damienmg/ender3_control_box/tank-hotend/params.scad

BLTOUCH_OFFSET = [40,0,0];
