damienmg/ender3_control_box/dual_z_plate/components.scad

use <3rdparty/Ender3/ender3.scad>

module Components() {
    Ender3WithoutScreen();
}

Components();
