damienmg/ender3_control_box/(list of files, cad)

Other CAD files:
psu_sonoff_cover/params.scad
control_box/colors.scad
