damienmg/ender3_control_box/(commit log)

2019-04-17 Added 3rd party STL for sizing.
2019-04-17 Added iteration 1 of the control box
    This control box enable to power the Raspberry Pi from the PSU of the
    Ender 3 and control the power of the printer itself, the power of a LED
    stripe and fans for the control box (cooling the RPi and the Buck
    converters).
    The Raspberry Pi control those using a Google AIY Voice Kit V1 (I use
    the servo control) but it can be done directly from the GPIO of the
    voice kit (just needs more wiring logic). I also intend to add an
    auxiliary box for the mic and the speaker of the Voice Kit so I can
    control my printer by voice :)
    Fixing is done using a mix of snap fit feet and brass inserts.
    [control_box.scad]
2019-04-17 Adapt the side fit in the extrusion
    The fit are good enough to hold the whole box, and the size should make
    them perfect to fit on the side of the Ender 3.
    [control_box.scad]
2019-04-17 Move the opening for the raspberry pi a bit higher
    It seems to be a bit too low currently (used a file to adapt it).
    [control_box.scad]
2019-05-20 Add a PSU cover for extra wire.
    It's probably not going to be used in fine.
    [psu_cover.scad]
2019-07-07 Initial redesign of the control box.
    This design is still pretty rough but should be printer for test. The
    front part is probably the first one to print since it can change the
    design of everything else. Second part to print would be the upper
    layer.
    The first thing to verify is that this does not prevent the Z axis from
    going all the way down.
    [control_box.scad, control_box_component_positions.scad, control_box_components.scad, psu_cover.scad]
2019-08-03 v2 of the box fixes after printing the front part
    This was testing with support enforcer on the front endcap and on the
    slider for the 40x40 extrusion. Pretty good except:
    - Add TODO for better support (e.g. missing support on the clip, too
    much support elsewhere).
    - The box was too high and colliding with the X gantry.
    - The endcap was in the wrong direction :)
    [control_box.scad]
2019-08-03 Adjust screw insert dimensions.
    [control_box.scad]
2019-08-03 Move the MOSFET cooling to be at the correct position
    [control_box.scad]
2019-08-03 Fix various position of the upper level after change of board dimensions.
    [control_box.scad]
2019-08-03 Reduce the size of the aluminum extrusion slider
    So they do not touch the endcap and prevent having support impossible
    to remove merge in between (although this could be solved in the slicer,
    it is better to fix it in the project).
    [control_box.scad]
2019-08-03 Add clearance for the upper level to go through
    Those clearance are so small that they should not need support.
    [control_box.scad]
2019-08-03 Make the lower bracket thicker (more solid)
    [control_box.scad]
2019-08-03 Decrease a bit the distance between step-down converter feet.
    They were too far apart from my LM2596S.
    [control_box.scad]
2019-08-03 Rewrite the endcap to be able to play for the size
    The one provided by Creality are too big to fit in the 40x40 extrusion,
    with some clearance they fit easily.
    [control_box.scad]
2019-08-03 Added some clearance to the endcap insert
    [control_box.scad]
2019-08-03 Cut out the part of the SKR13 feets that goes outside the board
    [control_box.scad]
2019-08-03 Fix M2 insert by doing through all insert
    Inserting the insert push plastic underneath and with just the good size
    the plastic come back inside the insert, clogging it. By using through
    all holes, we let space for the M2 insert plastic to be ejected.
    Also: remove trailing spaces
    [control_box.scad, control_box_components.scad]
2019-08-03 Raise the position of the mainboard port by 1mm
    The current print has the port 1 mm too low.
    [control_box.scad]
2019-08-03 Hopefully last adjustment for the upper level.
    - Fix the screw hole through size. It was always doing a M2 hole.
    - Increase the upper level bracket size to fit wire
    - Increase the upper level cable in hole size to fit wire
    - Add 1mm clearance (half a millimeter each side) on the bottom plate
    - Remove the power cable hole. The cable made assembly impossible so it
    is better to pass also the power by the other side.
    - Fix M2 and M3 insert size. There is a need to adjust them all.
    [control_box.scad]
2019-08-03 Several improvements after last print
    - removed pin for relay (plain feet)
    - removed bracket on the lower level (useless)
    - reduced the height of the raspberry pi USB port hole by 1mm
    (there was a 2.4mm clearance, too much).
    - removed part of the speaker support that block the upper level.
    - increased width clearance for the upper attachment.
    - added clearance on the cover to allow for it to slide nicely.
    - added cantilevers to force the 2 lower part to fit together.
    [control_box.scad]
2019-08-03 Remove some lug to increase the size of the cantilever
    [control_box.scad]
2019-08-03 Added proper position for the Raspberry Pi Standoffs
    [control_box.scad]
2019-08-03 Add fillets in a couple of places
    This make the edges of the box smoother.
    [control_box.scad]
2019-08-03 Cover: increase the length by 3 mm, total length by 1
    The insert that goes below the screen is now filletted and should
    adhere better to the screen inclination as well as print better without
    support.
    [control_box.scad]
2019-08-03 PCB snap fit: adjust a bit the clearance
    The previous version was too fit, there was not enough clearance and it
    was exercising to much stress on the PCB and on the snap fit.
    [control_box.scad]
2019-08-03 Upper level: do go through for the SKR 1.3 insert
    [control_box.scad]
2019-08-03 Add Apache 2.0 License and README
    [control_box.scad, control_box_component_positions.scad, control_box_components.scad]
2019-08-14 Adding a Bazel build to the SCAD files.
    This should allow good automation to generate all the artifact needed
    for printing. Hopefully I can complete that with some 3MF generation to
    handle support generation.
    [control_box.scad]
2019-08-14 Extract the colors in a separate scad file
    [colors.scad, control_box.scad, control_box_components.scad]
2019-08-14 Replace `for(...) children(c)` by `children()`
    [control_box.scad]
2019-08-14 Moved all the parameters to a separate params file
    Make it easier for people to adjust to their needs.
    [control_box.scad, params.scad]
2019-08-14 Update the brass inserts' diameters
    Set them to the full external diameter minus 1 mm. Before
    that they were set to the middle external diameter (where
    the brass is the thinner) but this was moving out too much
    plastic. This dimensions make it easy to insert those brass.
    [params.scad]
2019-08-15 Add custom support directly in the OpenSCAD model
    Slicer's support have been pretty bad and hard to remove. Try adding
    custom support that would be printed as part of the model.
    [colors.scad, control_box.scad, params.scad]
2019-08-17 Improve upper level
    - Increase size for MOSFET cooling.
    - Remove excessive cable bracket to only keep the useful one.
    - Remove a fixation hole that was inaccessible when needed.
    - Add a chamfer to the side to improve clearance when sliding the upper
    level in the box.
    [control_box.scad]
2019-08-17 Add a couple of bracket in the front of the box
    This should help with cable management a bit.
    [control_box.scad]
2019-08-17 Add place to attach a ziptie zipped around the cable
    [control_box.scad]
2019-08-17 Add better fixation for the upper cover
    This cover is now holded to all part of the box using a special slides.
    This should make sure the cover does not pop up at some place.
    [control_box.scad]
2019-08-17 Chamfer a last part that was having a steep overhang
    [control_box.scad]
2019-08-21 Lower the screen by 2 mm
    As measured by my caliper there seems to be 2 mm gap between the
    screen top and the box height.
    [control_box.scad, params.scad]
2019-08-21 Cover slide fit: reduce clearance and increase size
    This version result in almost no other movement than along the sliding
    direction.
    [control_box.scad]
2019-08-25 Add some interface layers to the support
    Theses interface layers draw a non continous part to ensure they do not
    stick hard on the part itself.
    Also increase the gap between support and wall as 0.5 is too close to
    the extrusion width and was fusing with the wall in some case.
    This make the support easy to remove.
    [control_box.scad, params.scad]
2019-09-14 Factor the endcap support
    Since they are linked to the endcap part, it is simpler to include them
    in the same function.
    [control_box.scad]
2019-09-14 Merged the endcap with the endcap support
    The endcap support was too weak and needed support anyway.
    This way should be stronger and not break when removing support. It
    prevents however to get the nice shiny finish from the bed on the
    endcap.
    [control_box.scad]
2019-09-22 Fixed direction of the cantilever support
    [control_box.scad]
2019-09-22 Adding 1 mm gap in the frame assembly screw
    This 1 mm gap should allow to use the actual frame as the limit.
    [control_box.scad]
2019-09-29 Initial version a PSU enclosure that can fit the sonoff basic R3 board
    [params.scad, psu_cover.scad]
2019-09-29 Remove PSU plug embossment
    This was to copy the original PSU enlosure but it does not seem
    useful and doesn't even improve the look. The 2mm wall thickness
    should be plenty for the screw to catch.
    [psu_cover.scad]
2019-09-29 Reduce the size of the hole for cable out
    As there is only the PSU out cable that goes through that hole and it
    should be possible to insert the PSU cable from the PSU connector, this
    is a safer option as it reduce access to the main voltage wiring.
    [psu_cover.scad]
2019-09-29 Add chamfer to the screw in
    This will help to guide the screw in the insert.
    [psu_cover.scad]
2019-09-29 Adding the power off scripts for the Sonoff with Tasmota
    Documentation is next
2019-10-05 Move the sonoff to the left
    This way the sonoff leave more space for the plug while still
    having space for its own cable.
    [params.scad]
2019-10-05 Cleanup: remove the useless translation of the model
    [psu_cover.scad]
2019-10-05 Rehaul of the sonoff insert
    The sonoff insert was making it hard to place and was leaving some
    access on it back create a potential short-circuit hazard. This
    change fixe those issue by creating a full plate for the back and
    only fixing the side of the sonoff on the bottom.
    [psu_cover.scad]
2019-10-05 Move the power plug a bit behind
    This also create an extrusion so the plug can actually leave enough
    clearance for the cable and the PSU.
    [params.scad, psu_cover.scad]
2019-10-05 Power plug: increase a big the screw in size
    This was too small and cracking a bit when screwing in.
    [psu_cover.scad]
2019-10-05 Increase a bit the width and height of the plug outside
    This should increase the strength and prevent further cracking when
    screwing in.
    [params.scad, psu_cover.scad]
2019-10-09 Reduce distance between buck converter
    This way the Raspberry Pi can be moved a few millimeter on the back.
    The border will be stronger this way, avoiding breaking that part.
    [control_box.scad, control_box_component_positions.scad, control_box_components.scad, params.scad]
2019-10-17 control_box: add an option to remove the fixation
    Removing the ender-3 fixation make it suitable for using
    with an enclosure (to deport the electronics out of the enclosure).
    [control_box.scad, params.scad]
2019-10-17 Add option to remove the AIY Kit
    For people that want to use this box without the AIY Kit.
    [control_box.scad, control_box_components.scad, params.scad]
2019-10-17 Stop using color to mark components and use %
    [colors.scad, control_box_components.scad]
2019-11-02 Start to support reverse direction
    This is a request to support mounting on the other side on a Ender 5.
    There is a little change to the cooling as the blower fan solution would
    not work well. Instead put 2 4010 for cooling the main board.
    This change just update the components position for the back as well as
    the 3d printed part for the bottom back.
    [control_box.scad, control_box_component_positions.scad, control_box_components.scad, params.scad]
2019-11-02 Add support for non blowing cooling across the board
    This just update the cover, the upper level also needs to be adapted
    [control_box.scad, control_box_components.scad, params.scad]
2019-11-09 Fix positioning of the mainboard
    There was some weird offset introduced in the y placement of the
    mainboard and this leds to very funny offset everywhere. Fixing it
    also simply fix the placement of the feet in reverse mode.
    [control_box.scad, control_box_components.scad, params.scad]
2019-11-09 Upper part are now ready for reverse mode
    Only the front screen needs to be adjusted now.
    [control_box.scad]
2019-11-09 Fix clearance on the endcap
    The clearance was applied inversely which led to a 1.5mm increase in
    width, oopsie!
    [control_box.scad]
2019-11-12 Front part also support the reverse mode
    The reverse mode should works all right now.
    [control_box.scad]
2019-11-12 Add a bit of clearance for cable to pass through
    The cable from the SKR 1.3 to the raspberry pi has nowhere to pass
    through and was kind of a difficult situation to wire. Adding a
    clearance would help people in the same situation.
    [control_box.scad]
2019-11-12 Add a 1mm offset when mounting on the right
    This should leave more room for the z stepper motor on the side.
    [control_box.scad, params.scad]
2019-11-13 Extract the feet in a separate OpenSCAD library
    [control_box.scad, feet.scad]
2019-11-13 Newer version where the upper level contains it walls
    This should make it easier to slide it with the board as well as
    make this part switchable with other (for switching board format).
    This is not finished. This version won't have enough attachment to
    the lower part. A better slide is needed.
    [control_box.scad]
2019-11-24 Second part of the new version: rails for the upper level
    The back as a rail to slide in the upper level.
    [control_box.scad, control_box_components.scad]
2019-11-28 Cleanup: use the screwin_diameter method for the fan feet
    This make it clearer what needs to be done on that side.
    [control_box.scad]
2019-12-03 Add a bit of clearance to be able to slide the cover easily
    This way the cover should be able to slide both way and we won't
    have to force in any direction to fix that.
    This change also fix the position of the tunnel with the new design.
    [control_box.scad]
2019-12-15 Add the possibility of putting a BTT UPS Mini 24V
    This replace one of the relay switch. In my case this
    is replacing the relay switch for the printer as
    I ended up always turning off the raspberry pi with the
    printer.
    Note: not yet printed, needs to be printed for correct testing. I intend
    to print it together with the reverse version.
    [control_box.scad, control_box_components.scad, feet.scad, params.scad]
2019-12-15 Support blower cooling for the stepper driver in reverse mode
    Unfortunately the intake of the blower cooling is coliding a bit
    with the Ender-3 frame but that should be fine.
    This is not yet tester but I'll switch to this reverse version
    soonish (after moving the power supply under my printer.
    [control_box.scad, control_box_components.scad, params.scad]
2019-12-28 Minor tweak to avoid gap between 90deg walls
    [control_box.scad, params.scad]
2019-12-29 Improve build plate adhesion of supports
    The support are sometime a bit too weak and fall down so increased the
    surface of the one causing isssues.
    [control_box.scad]
2019-12-30 Fix the position of the cable hole in reverse mode
    [control_box.scad]
2020-01-01 Add a version for the Creality Ender 3 mainboard footprint
    This is mainly designed to host SKR Mini E3 (DIP) version.
    [control_box.scad, control_box_components.scad, feet.scad, params.scad]
2020-01-01 Add the possibility of having a single 4010 for cooling
    For the melzi board that should be enough for cooling.
    [control_box.scad, control_box_components.scad, params.scad]
2020-01-05 Fix dimension of the upper box when using blower fan
    [control_box.scad]
2020-01-15 Add Ender 3 control panel
    Forgot to add this when added Melzi board support.
2020-01-15 Add a 8010 cooling solution
    [control_box.scad, control_box_components.scad, params.scad]
2020-02-16 First iteration of the modified tank hotend
    This is a hotend assembly inspired by the tank hotend that tries to
    address several issues:
    - Bad part cooling (fan too far)
    - Unavailability of the sources
    - Long filament path (this one keep the short one from the BMG
    extruder)
    - Difficult servicibility (need to disassemble part cooling to access
    fixation screw and then dissassemble the BMG extruder to remove the
    front part)
    This does not have wire going behind the hotend assembly either, which
    was a nice looking feature but make the assembly a bit harder to
    service.
    [components.scad, enclosure.scad, params.scad]
2020-02-18 Increase the BL-Touch attachment
    The previous one was too short and had less grip on the BlTouch Support.
    [enclosure.scad]
2020-02-20 Increase the size of the wire guide
    [enclosure.scad]
2020-02-20 WireGuide: change the shape so it is easier to print and more solid
    [enclosure.scad]
2020-02-20 Fix the bottom screw for the X-carriage
    The screw is inverted on the bottom one that has an excentric nut. This
    was the biggest issue in the first print as this was not fixable and
    made the first print impossible to correct mount.
    [enclosure.scad]
2020-02-20 Increase clearance for screw heads
    Also fix the BL touch support's support.
    [enclosure.scad]
2020-02-20 Adjust the clearance for the upper left wheel screw
    This should leave more space for the cable to go trough and improve
    overhangs.
    [enclosure.scad]
2020-02-20 Adjust the position of the E3D V6
    This correct the air vent position as well as the thickness of the
    BMG/E3V6 separation.
    [components.scad, enclosure.scad]
2020-02-23 Replace the BL-Touch support from one from Thingiverse
    This version is getting more clearance in exchange for needing a
    different position that the original tank hotend.
    [enclosure.scad, params.scad]
2020-02-23 Increase the strength of the arm holding the blower fan
    [enclosure.scad]
2020-02-26 Add chamfer to screw in for easier assembly.
    [enclosure.scad]
2020-02-26 Fix dimensions of the wire guide
    The previous version was a big too high and the hole for the screw
    was a bit too tight due to printing tolerance.
    [enclosure.scad]
2020-02-27 Increase the Bl-Touch support screw hole and size
    This should make the Bl-Touch more stable and allow for any M3 screw
    length.
    [enclosure.scad]
2020-02-29 Increase the size of the arm for the part cooling fan
    It was too short by 2mm on my printer so I increased the dimension a
    little. This also leave space to put in a M3 nut.
    [components.scad, enclosure.scad]
2020-02-29 Add an enclosure for the MP1584EN DC-DC Converter
    I use this DC-DC converter for powering a 12V 4010 heatsink fan. I have
    soldered a JST XH 2 pin connector near the negative power so the case
    has 2 holes: input cable goes from the rear and output cable from the
    JST connector.
    [components.scad, enclosure.scad]
2020-03-15 Adapt the wire guide to guide upward
    Guiding on the back was a dummy move as it would collide with the frame
    when on the left or right. This change also remove the DC-DC converter
    case, mine just go fine with electric tape between the X-carriage and
    the BMG extruder. I might consider doing an independent case that
    just slide directly there later.
    [components.scad, enclosure.scad]
2020-03-15 Make it clear that BL-Touch Support is imported
    [enclosure.scad]
2020-04-04 Remix a dual-Z plate for adding a wire guide
    As I use the right side Ender-3 Control box, I need to guide
    the tool head wire to the right. This adds a little notch on the
    plate so the wire can be attached to the second Z-rod plate.
    [components.scad, dual_z_plate.scad]
2020-04-04 Dual-Z plate: add a full flown cable guide
    This cable guide should guide better the cable for my right
    mounted control box.
    [dual_z_plate.scad]
2020-04-04 Dual-Z plate: increase the size of the ziptie hole
    It was a bit too tight fit so increasing the size should make it
    possible to hold the zip tie correctly.
    [dual_z_plate.scad]
2020-04-04 Improve the BL-Touch support and the cable guide
    Fix various issue related to Bl-Touch support and the cable guide:
    - Bl-touch support was not sturdy enough son integrated as part of the
    frame (not moving)
    - Wire guide was too tall
    - Wire guide was not sturdy so integrated it to the frame
    [components.scad, enclosure.scad]
2020-04-04 Lower the Bl-Touch by 0.5 mm
    The Z-offset was around 0.45mm at the moment which is a bit too short.
    [components.scad, enclosure.scad]
2020-05-08 Fix the dimension of the holes when not using insert
    The index was incorrect and it was creating holes of diameter 8
    instead of 4.5 for M5 threads.
    [feet.scad]
